MasonRhodesDev/marble-run-parts/docs/compatible-models.md

# Compatible published models

Parts other people published that fit the set's connector, with what we found
when printing them. Add a row whenever one is tried.

| Model | Source | Connector notes | Tried |
|---|---|---|---|
| Marble Run Alternating Diverter (UWcharlie1983) | https://www.printables.com/model/163082-marble-run-alternating-diverter and https://www.thingiverse.com/thing:3637025 | male inlet fits perfectly; female outlets drawn at 23.75 run slightly loose on the set's male | yes, 2026-10 |
| Marble Genius 3-way Splitter (Old Curmudgeon) | https://www.printables.com/model/42386-marble-genius-3-way-splitter | | no |
| Marble Genius 2-to-1 ramp (Old Curmudgeon) | https://www.printables.com/model/42381-marble-genius-2-to-1-ramp | | no |
| Marble Genius jump ramp (Old Curmudgeon) | https://www.printables.com/model/42380-marble-genius-jump-ramp | | no |
| Marble Genius Closed Spiral Section (Old Curmudgeon) | https://www.printables.com/model/42385-marble-genius-closed-spiral-section | | no |
| Marble Genius Spacer / 28.5mm Spacer / Support Cone / funnel top support (Old Curmudgeon) | Printables 42379, 42382, 42384, 42383 | | no |
| Marble Genius Spacer, hex male end (Gage Cullum) | https://www.printables.com/model/1363782 | | no |
| Marble Genius Quick Release (Gage Cullum) | https://www.printables.com/model/1363791 | | no |

## Not compatible, so nobody tries again

| Model | Why |
|---|---|
| Marble Run Bowls, Joyin compatible (brimstone326, Printables 1700829) | 25.4 mm male; scaled to 23.6 it was still wrong for the set and the shallow bowl needs dense supports on a finished face |
| Quadrilla, Hubelino, Gravitrax, Hape, Out of Marbles modules | different systems |
