MasonRhodesDev/marble-run-parts/(commit log)

2026-10-23 Connector spec, OpenSCAD library and vortex part for the tube marble run
    Claude-Session: https://claude.ai/code/session_01S2gyox1fXT3RmmRRns5AoV
    [vortex.scad]
2026-10-23 Match the set: 6.5 mm male end with tip chamfer, 8 mm socket with mouth lead-in; log coupon v1
    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
    [vortex.scad]
2026-10-23 Record the print settings behind the fit log
    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
2026-10-23 Define the unit height (32.92 mm pitch) and record the base piece overall height
    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
2026-10-23 Correct the unit height to 34.91 mm; male end is exactly the 6.4 difference
    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
2026-10-23 Vortex: size the body to two set units via ms_units
    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
    [vortex.scad]
2026-10-23 Record 2.2 mm walls, 18.5 mm passage and the full-depth socket with seat ring; match them in the library
    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
2026-10-23 Add the one-unit straight tube as a reference part
    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
    [tube.scad]
2026-10-23 Male end extends 1 mm into the body; socket floor sits on it
    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
    [tube.scad, vortex.scad]
2026-10-23 Make the 1 mm male overlap a stated constraint, enforced by assert
    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
2026-10-23 Feature declarations and ms_check conditional constraints; both parts wired
    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
    [tube.scad, vortex.scad]
2026-10-23 Socket keep-out: plain bore for the male end plus 1 mm before any feature
    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
    [tube.scad, vortex.scad]
2026-10-23 Library rewrite after review: checks in drawing modules, include-time constant asserts, geometric keep-out test; vortex flipped to male inlet on top and female outlet below
    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
    [tube.scad, vortex.scad]
2026-10-23 Vortex: iteration notes and handoff after the v2 print
    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
2026-10-23 Vortex v3: real 45 degree ramp in the inlet shaft and a window that no longer cuts the bowl
    The shaft floor is now a 45 degree plane falling to the sill on the +y side. The sill is set 2 mm above the bowl surface at the tower exit point, every tower cut has the bowl shell subtracted, and the window is clipped to the tower cylinder and to above the ramp. Notes updated with the v3 print log row.
    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
    [vortex.scad]
2026-10-23 Vortex notes: v3 print started with the second stringing pass
    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
2026-10-23 Male keep-out: uninterrupted ring and clear bore from the tip through the overlap plus 1 mm, probed like the socket
    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
    [tube.scad]
2026-10-23 Vendor BOSL2 as a submodule for sweeps and rounding
    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
    [vortex.scad]
2026-10-23 Vortex v4: inlet redesigned as an outside drop tube with a rounded scoop and a tangential trough
    The drop tube stands outside the lip with the male end on top at exactly two units. A rounded scoop and a shallow descending trough cross the lip through a window and end flush with the lip inner face, so nothing of the inlet is inside the bowl. The cut stops below the male keep-out and the bore is cut past the tip. A small wedge under the inlet replaces the large skirt. ms_males is declared, preview uses fewer facets, and the notes record v3 as cancelled and v4 as awaiting inspection.
    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
    [vortex.scad]
2026-10-23 Vortex v5: three units, drop tube outside the lip on a 45 degree corbel, 20 mm scoop, 20 degree trough; approved for printing
    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
    [vortex.scad]
2026-10-23 Vortex notes: v5 print started
    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
2026-10-24 vortex: log v5 brim reprint ran out of filament near the top
    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
2026-10-24 vortex: v5 reprint at 210 on PLA+, runout sensor on PA7
    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
